L71/MS20VCF/README.md

# MS20VCF
Korg MS20 style VCF eurorack module

8HP Eurorack module based on this schematic: http://electro-music.com/wiki/pmwiki.php?n=Schematics.KorgLateMS20Filter

See also https://l71.github.io/ for more info.
