L71/MS20VCF/MS20vcf.brd

## EAGLE design MS20vcf.brd (2019-04-27)

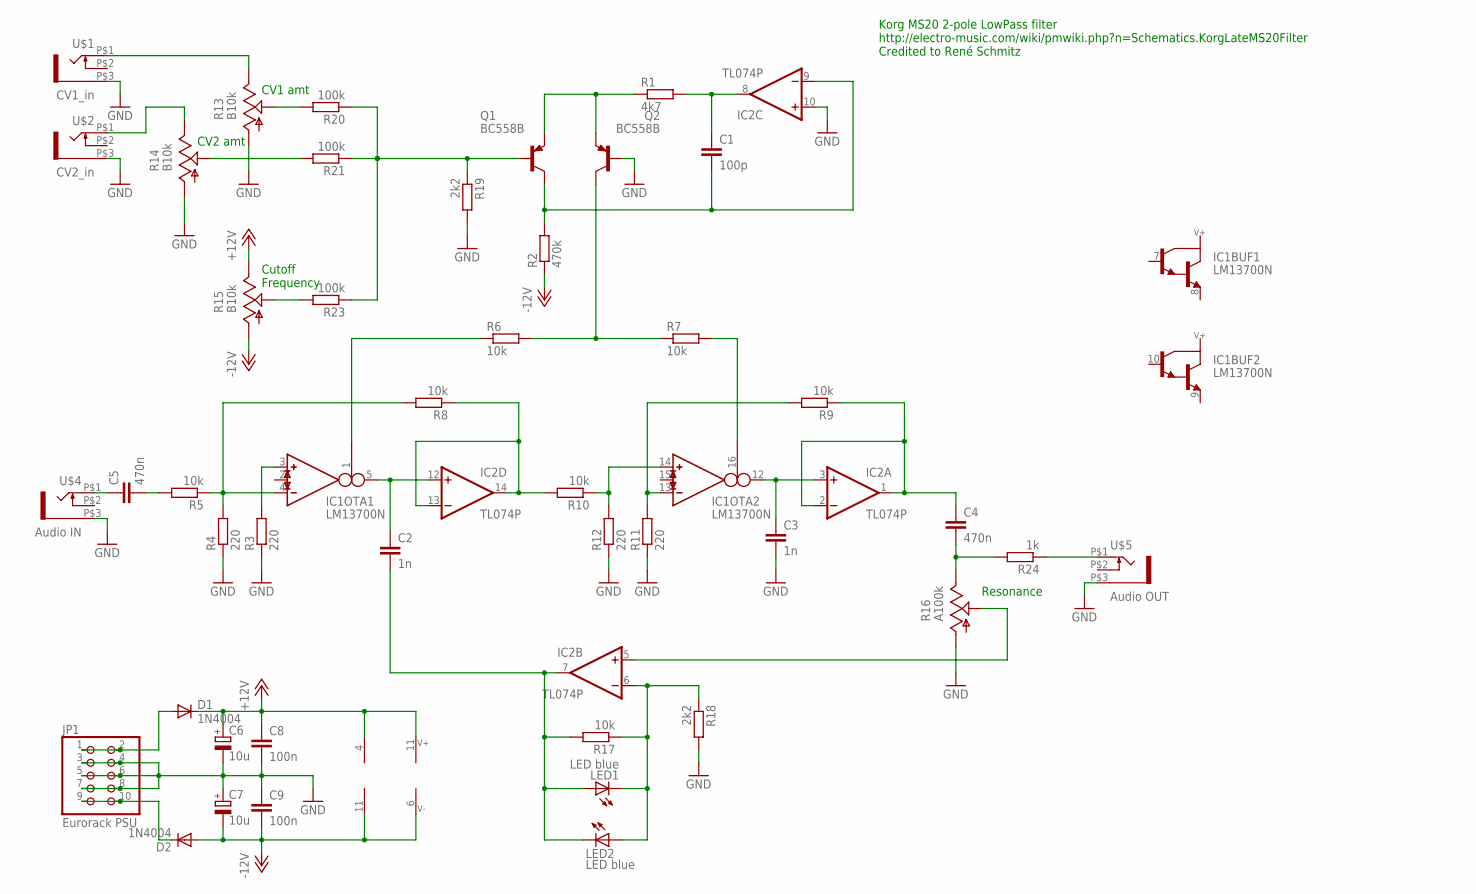
[picture p1: schematic MS20vcf.sch]

Parts:
C1: 100p; C025-025X050
C2, C3: 1n; C050-025X075
C4, C5: 470n; C050-025X075
C6, C7: 10u; E2,5-5
C8, C9: 100n; C025-025X050
D1, D2: 1N4004; D-7.5
IC1: LM13700N; DIL16
IC2: TL074P; DIL14
JP1: Eurorack PSU; 2X05
LED1, LED2: LED blue; LED3MM
Q1, Q2: BC558B; TO92-EBC
R1: 4k7; 0207/2V
R2: 470k; 0207/2V
R3, R4, R11, R12: 220; 0207/2V
R5, R6, R7, R8, R9, R10, R17: 10k; 0207/2V
R13, R14, R15: B10k; ALPS_POT_VERTICAL
R16: A100k; ALPS_POT_VERTICAL
R18, R19: 2k2; 0207/2V
R20, R21, R23: 100k; 0207/2V
R24: 1k; 0207/2V
U$1: CV1_in; WQP-PJ301M-12_JACK
U$2: CV2_in; WQP-PJ301M-12_JACK
U$4: Audio IN; WQP-PJ301M-12_JACK
U$5: Audio OUT; WQP-PJ301M-12_JACK

Connections:
+12V: C6.+, C8.1, D1.C, IC1.11 (V+), IC2.4 (V+), R15.P$1 (E)
-12V: C7.-, C9.2, D2.A, IC1.6 (V-), IC2.11 (V-), R2.1, R15.P$3 (A)
GND: C3.2, C6.-, C7.+, C8.2, C9.1, IC2.10 (+IN), JP1.3, JP1.4, JP1.5, JP1.6, JP1.7, JP1.8, Q2.B, R3.1, R4.1, R11.1, R12.1, R13.P$3 (A), R14.P$3 (A), R16.P$3 (A), R18.2, R19.2, U$1.P$3 (1), U$2.P$3 (1), U$4.P$3 (1), U$5.P$3 (1)
unnamed: C1.1, IC2.8 (OUT), R1.2
unnamed: Q1.E, Q2.E, R1.1
unnamed: C1.2, IC2.9 (-IN), Q1.C, R2.2
unnamed: Q2.C, R6.2, R7.1
unnamed: IC1.1 (I_BIAS), R6.1
unnamed: IC1.16 (I_BIAS), R7.2
unnamed: C2.1, IC1.5 (OUT), IC2.12 (+IN)
unnamed: C3.1, IC1.12 (OUT), IC2.3 (+IN)
unnamed: IC1.13 (IN_N), R9.2, R11.2
unnamed: IC1.3 (IN_P), R3.2
unnamed: IC1.4 (IN_N), R4.2, R5.1, R8.2
unnamed: IC2.13 (-IN), IC2.14 (OUT), R8.1, R10.2
unnamed: IC1.14 (IN_P), R10.1, R12.2
unnamed: IC2.6 (-IN), LED1.K (C), LED2.A, R17.1, R18.1
unnamed: C4.1, IC2.1 (OUT), IC2.2 (-IN), R9.1
unnamed: C5.2, R5.2
unnamed: C4.2, R16.P$1 (E), R24.2
unnamed: IC2.5 (+IN), R16.P$2 (S)
unnamed: C2.2, IC2.7 (OUT), LED1.A, LED2.K (C), R17.2
unnamed: Q1.B, R19.1, R20.1, R21.1, R23.1
unnamed: R15.P$2 (S), R23.2
unnamed: R13.P$1 (E), U$1.P$1 (2)
unnamed: R14.P$2 (S), R21.2
unnamed: R13.P$2 (S), R20.2
unnamed: R14.P$1 (E), U$2.P$1 (2)
unnamed: C5.1, U$4.P$1 (2)
unnamed: R24.1, U$5.P$1 (2)
unnamed: D1.A, JP1.1, JP1.2
unnamed: D2.C, JP1.9, JP1.10

Notes on the sheet:
Resonance
CV2 amt
CV1 amt
Cutoff Frequency
Korg MS20 2-pole LowPass filter http://electro-music.com/wiki/pmwiki.php?n=Schematics.KorgLateMS20Filter Credited to René Schmitz

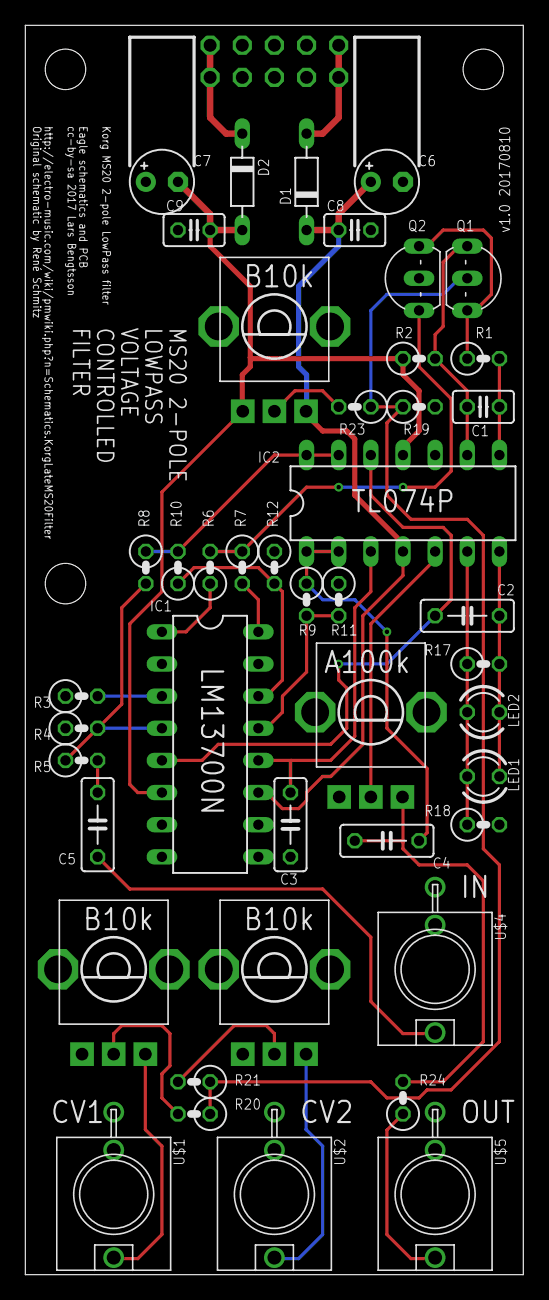
[picture p2: board MS20vcf.brd from above]

Board: 2 copper layers, 39.4 x 98.7 mm, 45 parts (1 on the bottom side), 32 nets.
