L71/MS20VCF/(commit log)

2017-08-26 Initial commit. Prototype built OK.
    [MS20-1.0-8HP-PCB-panel.brd, MS20vcf.brd, MS20vcf.sch]
2017-08-29 Moved C3 to clear potentiometer, added value labels to potentiometers.
    [MS20vcf.brd]
2019-04-27 Moved transistor pair closer.
    [MS20vcf.brd]
