L71/MS20VCF/(notices)

Notices in the files:
MS20vcf.brd:
cc-by-sa 2017 Lars Bengtsson
